twentyfivefishinthetoilet/mallow/cad/README.md

## the assembled and disassembled file is twice the size that github will let me upload...

find the assembled and disassembled models here: https://cad.onshape.com/documents/8d28d937ee2f633915ee1e28/w/bbd2f0516e2d8f6c5a6715a7/e/e605bfe08fafb4b1c2a4257e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 

sorry for the inconvenience :(
