twentyfivefishinthetoilet/mallow/bom.csv

Item Name | Qty | Price (total) (USD) | Item link | Notes | Backup links (Digikey/Amazon)
misc. SMD 0805 caps | 1 | $3.32 | https://www.aliexpress.us/item/2251832835333921.html | this applies for everything on aliexpress: listings may go down, prices may fluctuate. everything listed here is what i paid for as of october 2026. | https://a.co/d/07zyfSbP
misc. SMD 0603 resistors | 1 | $2.59 | https://www.aliexpress.us/item/3256811933609419.html |  | https://a.co/d/0jb2nH2L
USB-C ports (12pin) | 1 | $2.12 | https://www.aliexpress.us/item/3256812000821907.html |  | https://a.co/d/01DCsopN
2x10 2.54mm Female Header | 1 | $2.18 | https://www.aliexpress.us/item/3256805557045362.html | one for the game cartridge port, one of them for the controller port | https://www.digikey.com/en/products/detail/marutsuelec/21602X10GRE/21669225
2x10 2.54mm Male Header | 1 | $5.27 | https://www.aliexpress.us/item/2255801071217675.html?curPageLogUid=68oLz2krU5b1 | one for the game cartridge, one of them for the controller | https://www.digikey.com/en/products/detail/w-rth-elektronik/61302021021/4846861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
ESP32 S3 | 1 | $7.65 | https://www.aliexpress.us/item/3256805599889662.html | wroom 1u (n16r8 variant) | https://www.digikey.com/en/products/detail/espressif-systems/ESP32-S3-WROOM-1U-N16R8/16162641
LD1117S33TR | 1 | $1.61 | https://www.aliexpress.us/item/2251832820774962.html | voltage regulator 5v -> 3.3v | https://www.digikey.com/en/products/detail/stmicroelectronics/LD1117S33TR/585766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
ST7789 40pin | 1 | $14.43 | https://www.aliexpress.us/item/3256805323917526.html | Bundle: IPS Capacitive | couldn't find a backup link for this one, but this listing keeps popping up all over aliexpress. look up "2.8 inch TFT display 40PIN IPS full viewing angle", and if it matches the pinout on my schematic, then you're golden
FPC connector | 2 | $4.45 | https://www.aliexpress.us/item/3256812318345505.html | one order 6 pins at 0.5mm pitch, another at 40 pins at 0.5mm pitch | https://www.digikey.com/en/products/detail/amphenol-icc-fci-/62684-401100AHLF/4272376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
TF/microSD card slot | 1 | $8.71 | https://www.aliexpress.us/item/3256813046919379.html |  | https://www.digikey.com/en/products/detail/same-sky-formerly-cui-devices-/MSD-9-A/21796102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
MCP23017T-E/SS | 1 | $7.63 | https://www.aliexpress.us/item/3256812791682296.html |  | https://www.digikey.com/en/products/detail/microchip-technology/MCP23017T-E-SS/964185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
push buttons | 1 | $1.78 | https://www.aliexpress.us/item/3256802301084670.html | 6x6x6mm | https://www.amazon.com/Momentary-Terminal-Pushbutton-Breadboard-Electronic/dp/B09R3ZPWJ7
push buttons (smd) | 1 | $2.22 | https://www.aliexpress.us/item/3256811531075750.html?curPageLogUid=lURo5QRmlVZe | 3×6×2.5mm | https://www.amazon.com/100pcs-3X6X2-5mm-Tactile-Button-Switch/dp/B0F7GGCFCY
charging module | 1 | $2.25 | https://www.aliexpress.us/item/3256810363878930.html?curPageLogUid=32djJhgpSeSi | Color: TP4056 MICRO 5PCS | https://www.amazon.com/DEVMO-Charging-Lithium-Protection-Function/dp/B07S5ZV8FD?sp_csd=d2lkZ2V0TmFtZT1zcF9hdGY
3.7V 602030 300mAh | 1 | $6.44 | https://www.aliexpress.us/item/3256812728637526.html?curPageLogUid=clhgQjHo0G6X | this isnt the exact battery i have, but it's the closest i could find. same power rating, maybe different dimensions. | https://www.amazon.com/BORNMIO-Lithium-Polymer-Rechargeable-Connector/dp/B0D4V7KLSV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
misc: jumper wires, switch, etc |  | $5.00 | - | 5 is a generous grace amount for jumper wires, a switch for the power pak, and 1x2 female header pins (optional). | -
W25Q128FWSIQ | 1 | $2.81 | https://www.aliexpress.us/item/3256808455873288.html?curPageLogUid=pTRUNNN6MLek |  | https://www.amazon.com/5PCS-25Q128FWSQ-W25Q128FWSQ-W25Q128FWSIQ-SOP8/dp/B0C557DY1J
Total Price (USD) (FROM ALIEXPRESS): | $80.46
