twentyfivefishinthetoilet/mallow/cad/controller/base_bottom.stl

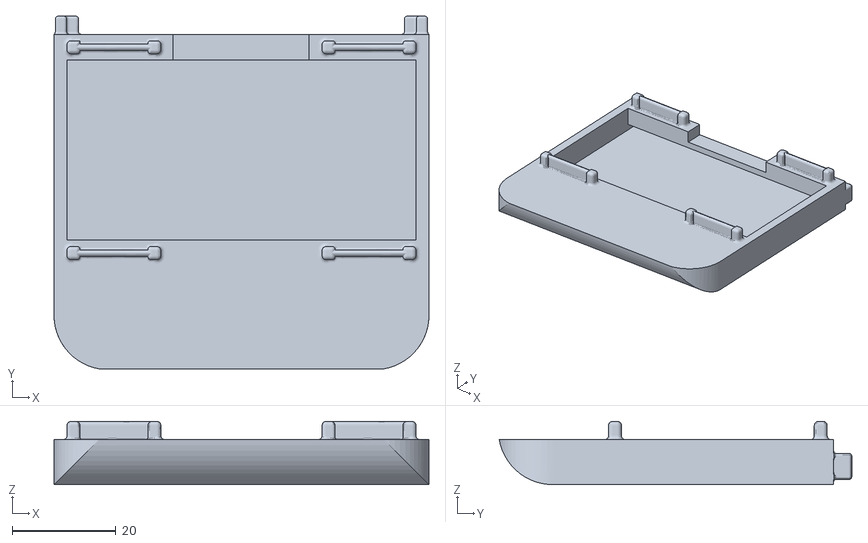
[picture p5: CAD file, 2026-10-20]
cad/controller/base_bottom.stl
72.3 x 68.0 x 12.2
