twentyfivefishinthetoilet/mallow/cad/game_cartridge/Part Studio 3 - Part 2.obj

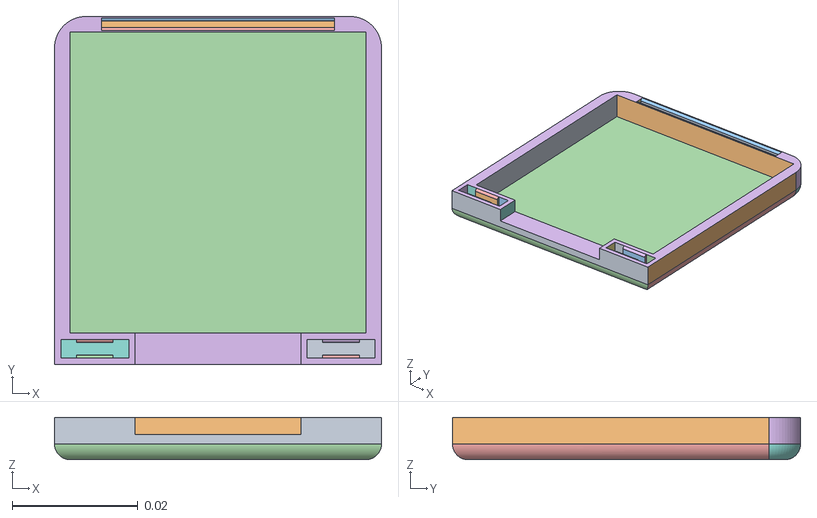
[picture p6: CAD file, 2026-10-19]
cad/game_cartridge/Part Studio 3 - Part 2.obj
0.052 x 0.0553 x 0.00675
