twentyfivefishinthetoilet/mallow/cad/main_board/Part Studio 1 - Part 3.obj

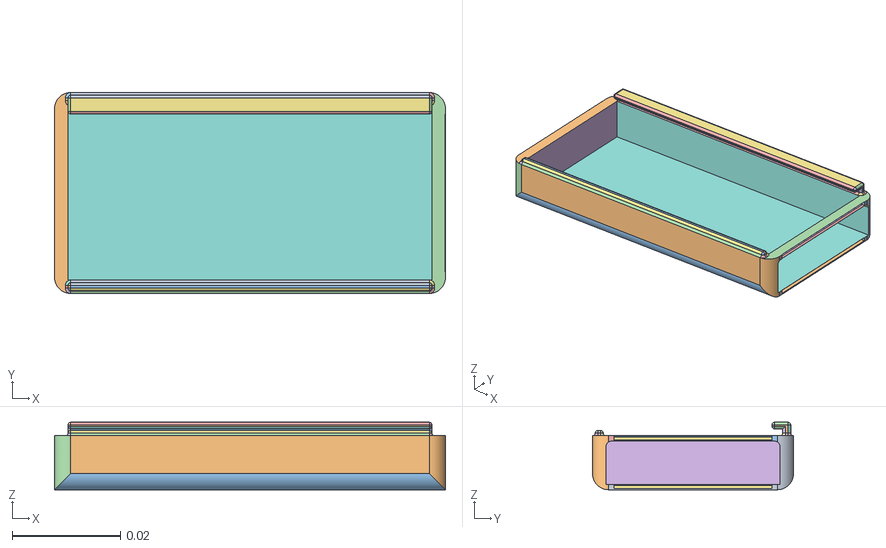
[picture p7: CAD file, 2026-10-19]
cad/main_board/Part Studio 1 - Part 3.obj
0.0723 x 0.0372 x 0.0125
