twentyfivefishinthetoilet/mallow/cad/STEP/controller_step/top.step

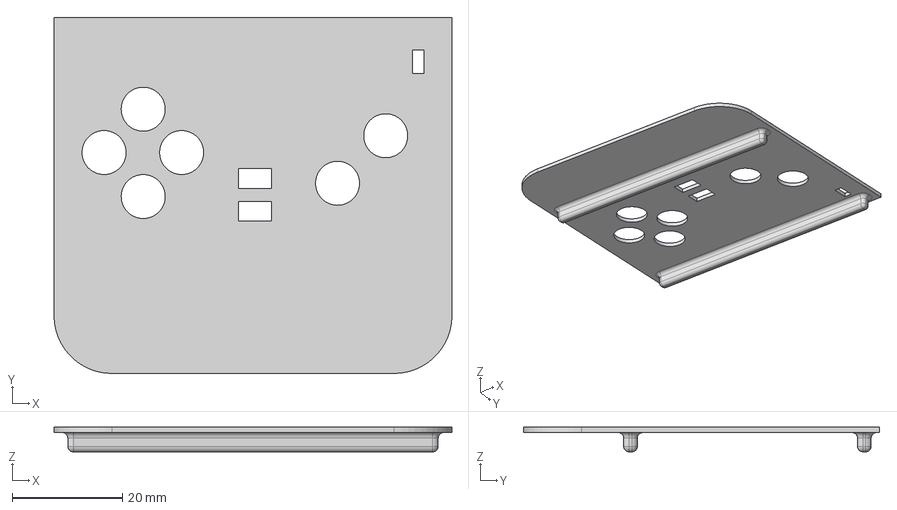
[picture p8: CAD file, 2026-10-23]
cad/STEP/controller_step/top.step
72.4 x 64.7 x 4.50 mm
