twentyfivefishinthetoilet/mallow/cad/STEP/game_cartridge_step/bottom.step

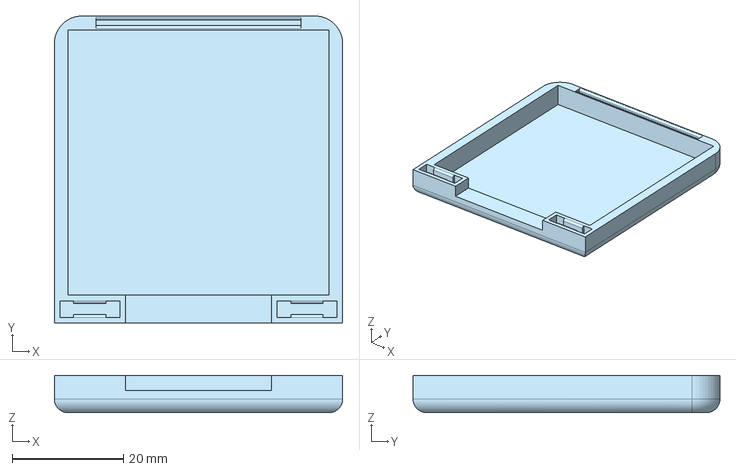
[picture p9: CAD file, 2026-10-23]
cad/STEP/game_cartridge_step/bottom.step
52.0 x 55.3 x 6.75 mm
