twentyfivefishinthetoilet/mallow/cad/STEP/main_board_step/power_pak.step

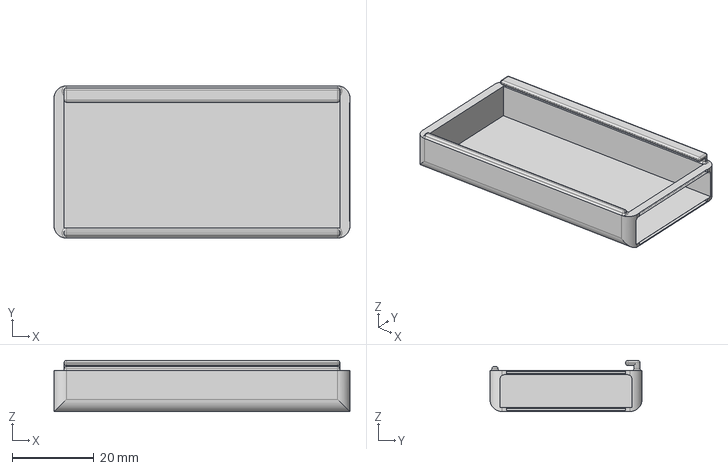
[picture p10: CAD file, 2026-10-23]
cad/STEP/main_board_step/power_pak.step
72.4 x 37.2 x 12.5 mm
