twentyfivefishinthetoilet/mallow/cad/STL/controller/buttons_A.stl

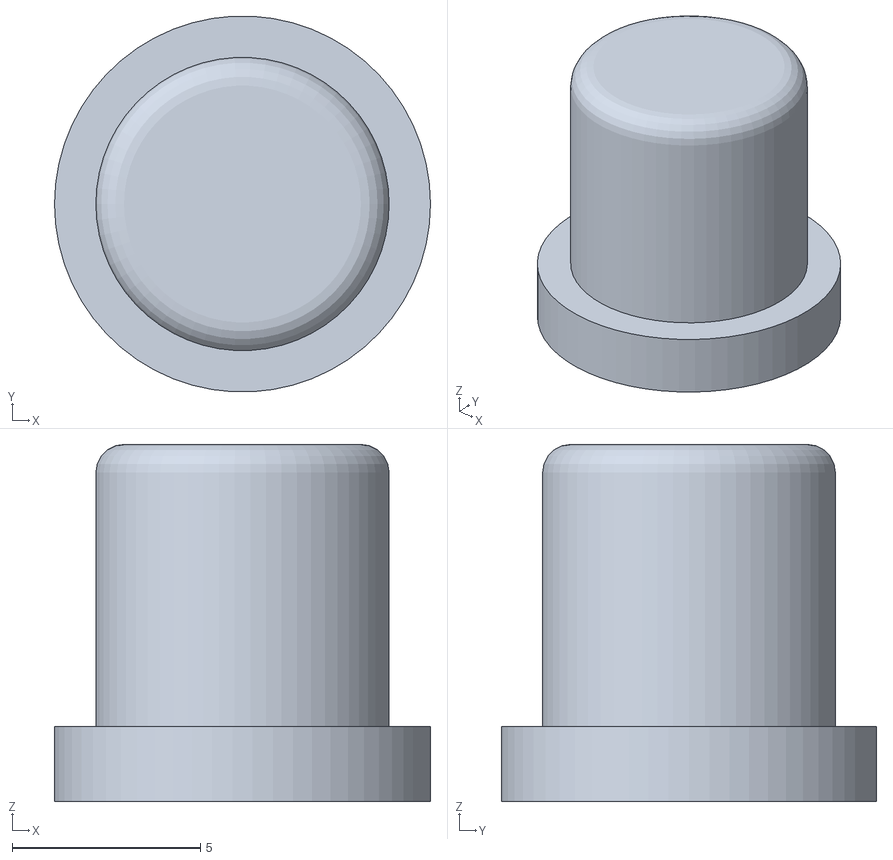
[picture p11: CAD file, 2026-10-23]
cad/STL/controller/buttons_A.stl
10.0 x 9.99 x 9.50
