twentyfivefishinthetoilet/mallow/cad/controller/base_middle.stl

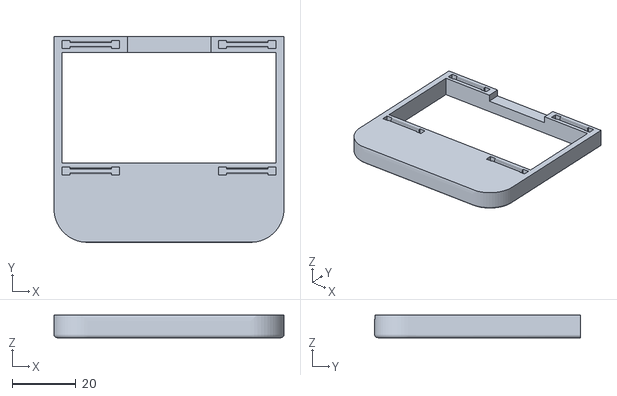
[picture p12: CAD file, 2026-10-20]
cad/controller/base_middle.stl
72.3 x 64.7 x 7.08
