twentyfivefishinthetoilet/mallow/cad/game_cartridge/Part Studio 3 - Part 1.obj

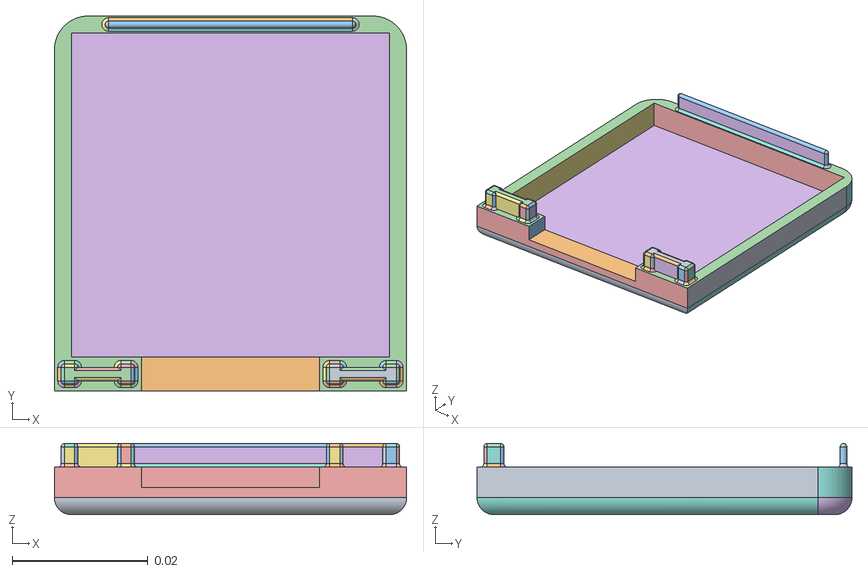
[picture p13: CAD file, 2026-10-19]
cad/game_cartridge/Part Studio 3 - Part 1.obj
0.0519 x 0.0553 x 0.0105
