twentyfivefishinthetoilet/mallow/cad/main_board/Part Studio 1 - Part 2.obj

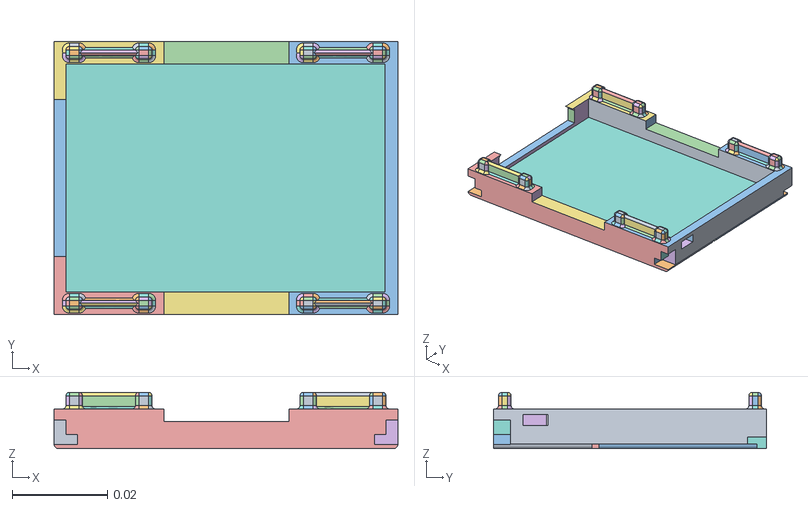
[picture p14: CAD file, 2026-10-19]
cad/main_board/Part Studio 1 - Part 2.obj
0.0723 x 0.0573 x 0.0119
