twentyfivefishinthetoilet/mallow/cad/STEP/controller_step/dpad.step

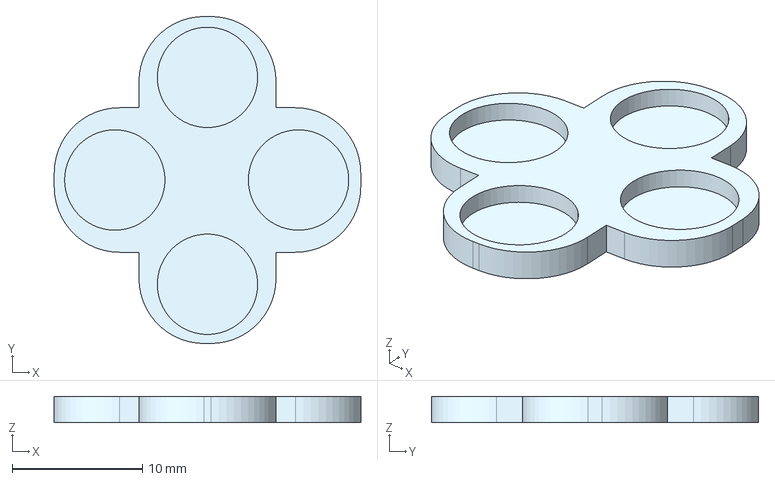
[picture p15: CAD file, 2026-10-23]
cad/STEP/controller_step/dpad.step
23.5 x 25.1 x 2.00 mm
