twentyfivefishinthetoilet/mallow/cad/STEP/game_cartridge_step/top.step

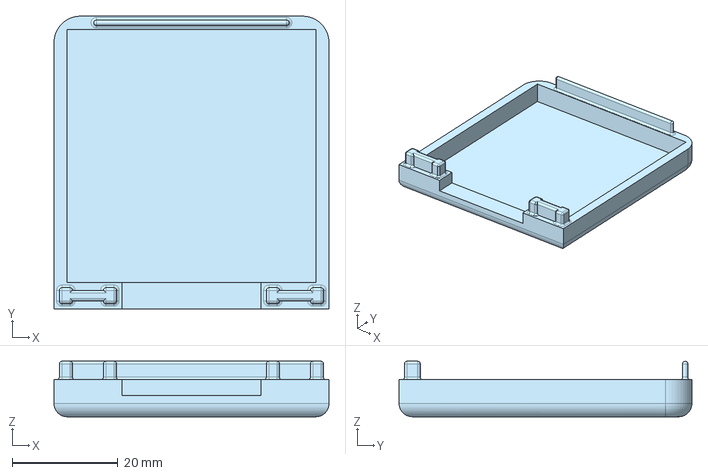
[picture p16: CAD file, 2026-10-23]
cad/STEP/game_cartridge_step/top.step
51.9 x 55.3 x 10.5 mm
