twentyfivefishinthetoilet/mallow/cad/STEP/main_board_step/bottom.step

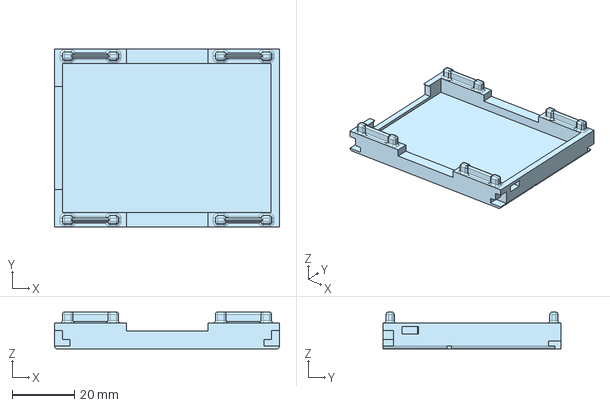
[picture p17: CAD file, 2026-10-23]
cad/STEP/main_board_step/bottom.step
72.4 x 57.3 x 11.9 mm
