twentyfivefishinthetoilet/mallow/cad/STL/controller/buttons_A_cover.stl

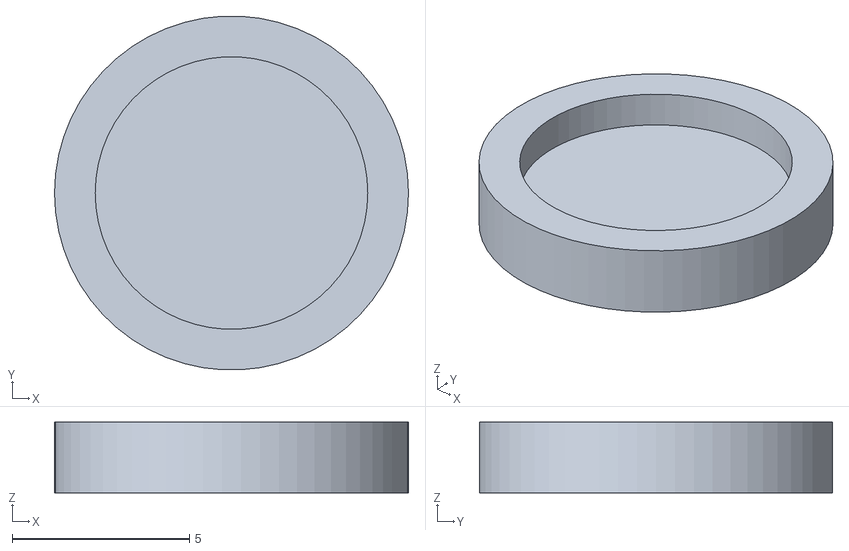
[picture p18: CAD file, 2026-10-23]
cad/STL/controller/buttons_A_cover.stl
10.0 x 9.99 x 2.00
