twentyfivefishinthetoilet/mallow/cad/main_board/Part Studio 1 - Part 1.obj

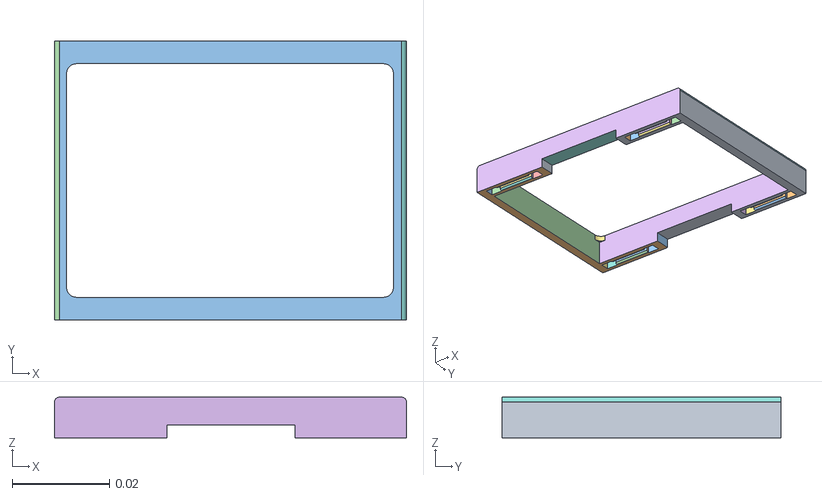
[picture p19: CAD file, 2026-10-19]
cad/main_board/Part Studio 1 - Part 1.obj
0.0724 x 0.0573 x 0.00838
