twentyfivefishinthetoilet/mallow/cad/STEP/main_board_step/top.step

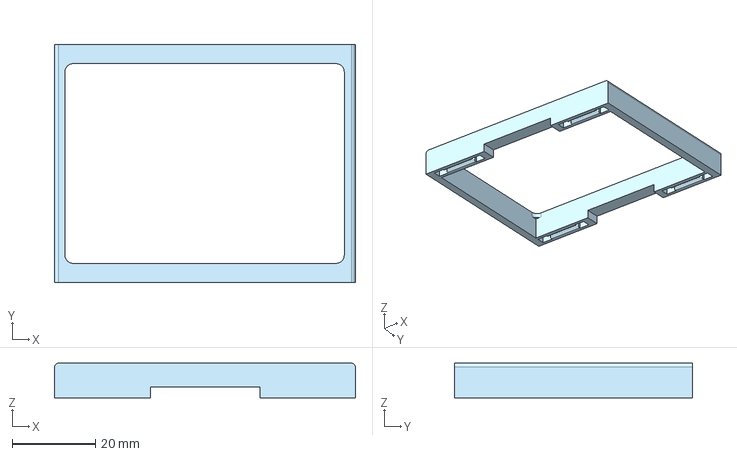
[picture p20: CAD file, 2026-10-23]
cad/STEP/main_board_step/top.step
72.3 x 57.3 x 8.38 mm
