twentyfivefishinthetoilet/mallow/cad/controller/Part Studio 2 - Part 3.obj

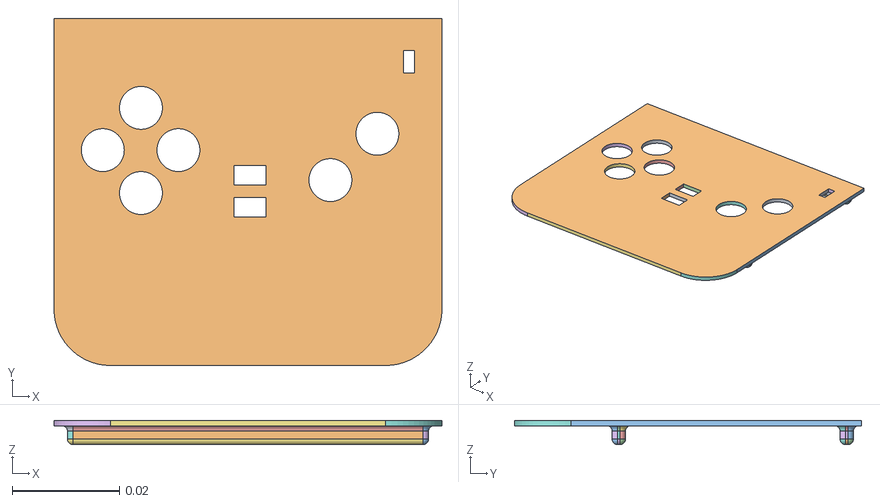
[picture p21: CAD file, 2026-10-19]
cad/controller/Part Studio 2 - Part 3.obj
0.0724 x 0.0647 x 0.0045
