twentyfivefishinthetoilet/mallow/cad/controller/Part Studio 2 - Part 7.obj

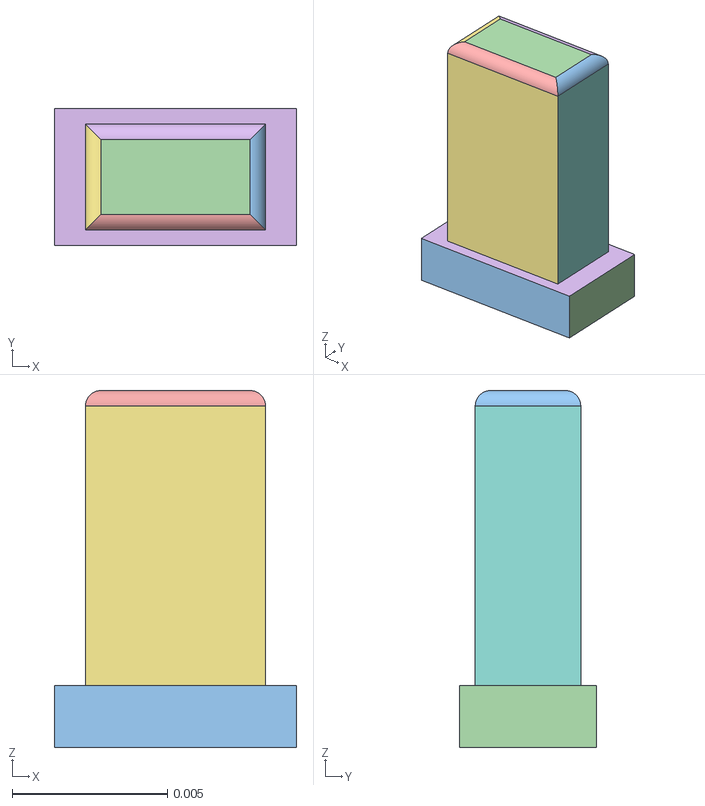
[picture p22: CAD file, 2026-10-19]
cad/controller/Part Studio 2 - Part 7.obj
0.0078 x 0.0044 x 0.0115
