twentyfivefishinthetoilet/mallow/cad/STEP/controller_step/button_A.step

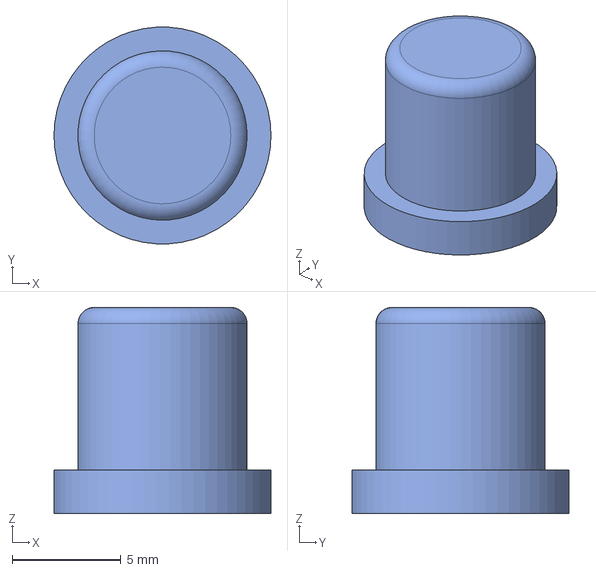
[picture p23: CAD file, 2026-10-23]
cad/STEP/controller_step/button_A.step
10.00 x 9.98 x 9.50 mm
