twentyfivefishinthetoilet/mallow/cad/controller/Part Studio 2 - Part 5.obj

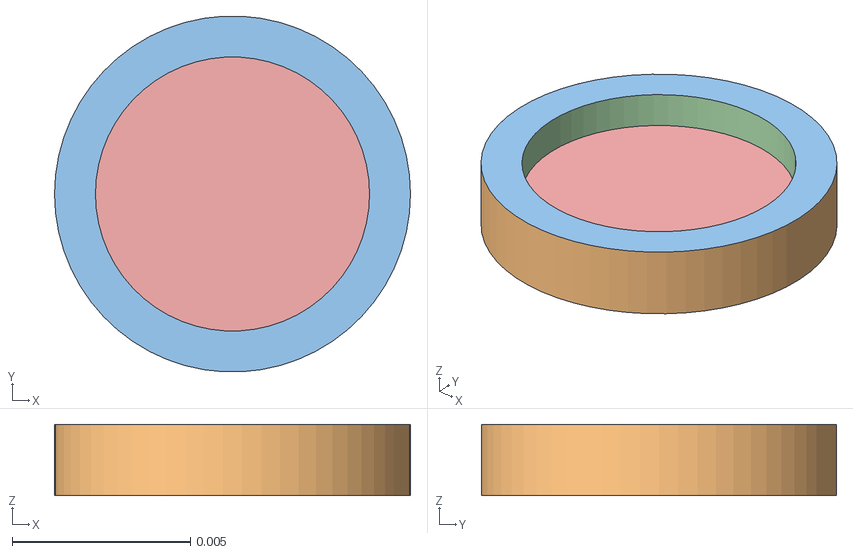
[picture p24: CAD file, 2026-10-19]
cad/controller/Part Studio 2 - Part 5.obj
0.01 x 0.00999 x 0.002
