twentyfivefishinthetoilet/mallow/cad/STEP/controller_step/buttons_B.step

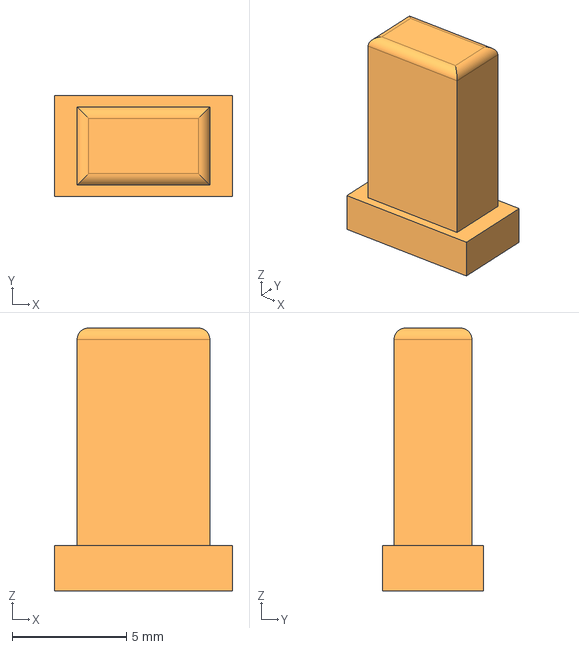
[picture p25: CAD file, 2026-10-23]
cad/STEP/controller_step/buttons_B.step
7.80 x 4.40 x 11.5 mm
