twentyfivefishinthetoilet/mallow/cad/controller/Part Studio 2 - Part 2.obj

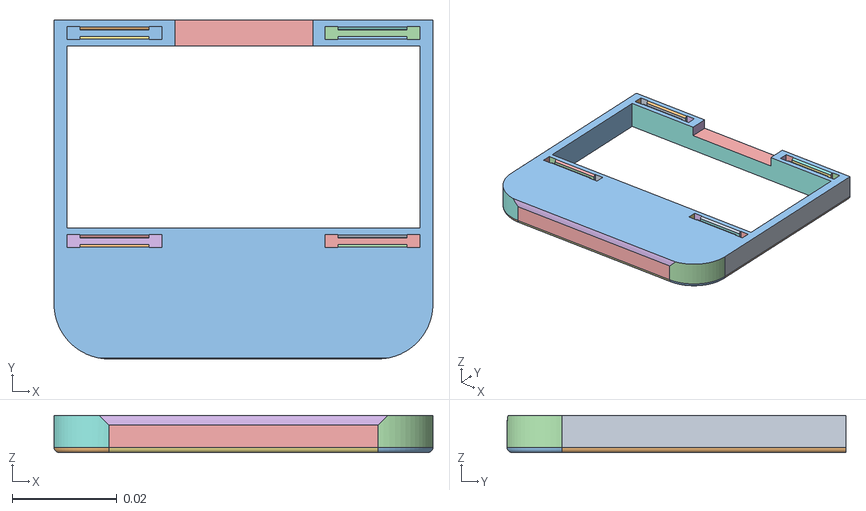
[picture p26: CAD file, 2026-10-19]
cad/controller/Part Studio 2 - Part 2.obj
0.0723 x 0.0647 x 0.00708
