twentyfivefishinthetoilet/mallow/cad/controller/Part Studio 2 - Part 8.obj

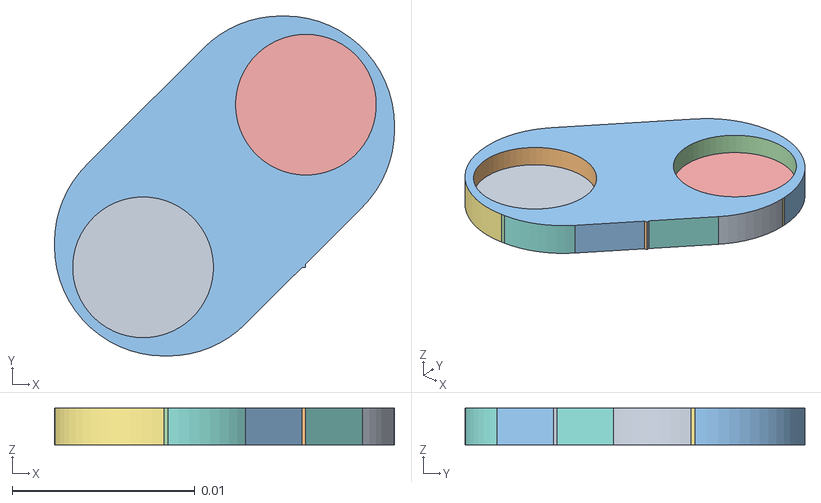
[picture p27: CAD file, 2026-10-19]
cad/controller/Part Studio 2 - Part 8.obj
0.0186 x 0.0186 x 0.002
