twentyfivefishinthetoilet/mallow/cad/controller/Part Studio 2 - Part 6.obj

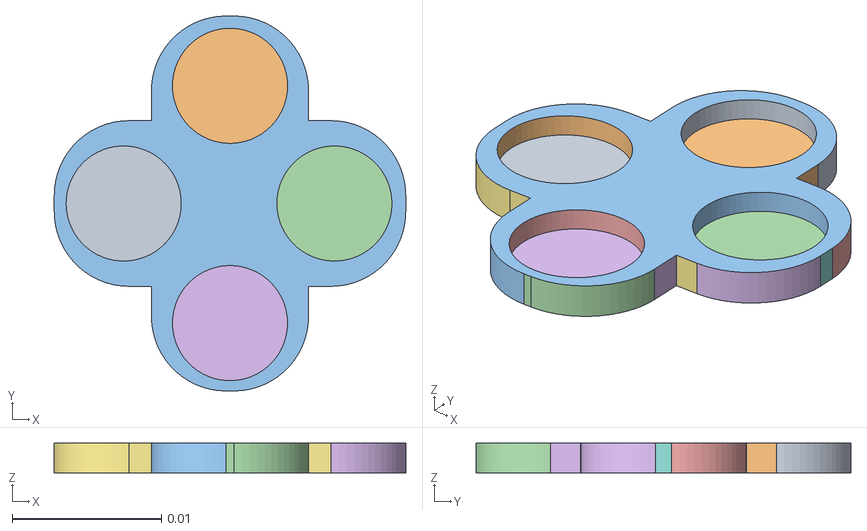
[picture p28: CAD file, 2026-10-19]
cad/controller/Part Studio 2 - Part 6.obj
0.0235 x 0.0251 x 0.002
