twentyfivefishinthetoilet/mallow/cad/controller/Part Studio 2 - Part 4.obj

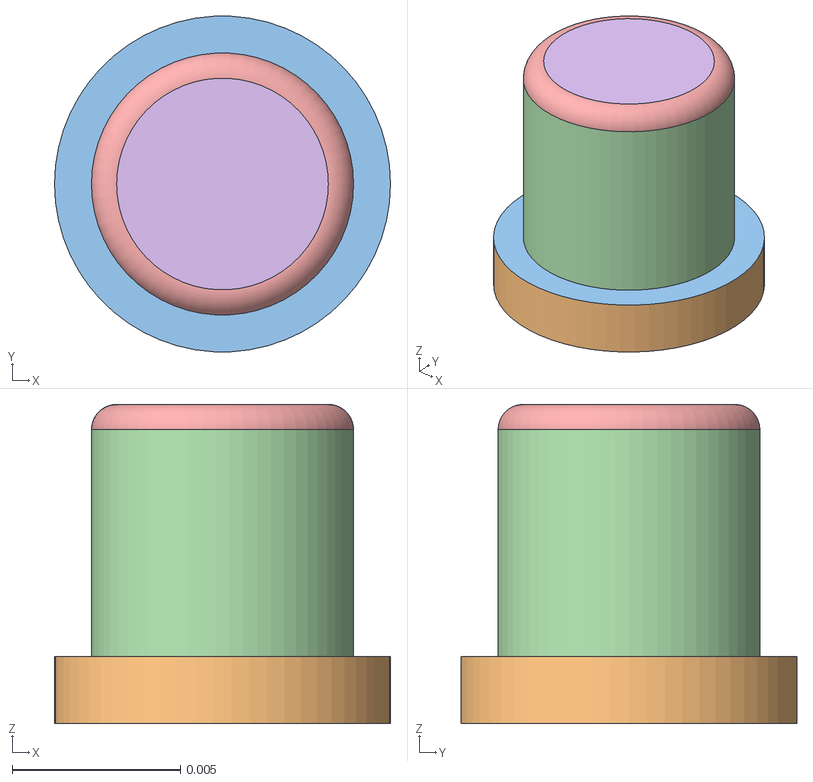
[picture p29: CAD file, 2026-10-19]
cad/controller/Part Studio 2 - Part 4.obj
0.01 x 0.00999 x 0.0095
