twentyfivefishinthetoilet/mallow/cad/controller/Part Studio 2 - Part 1.obj

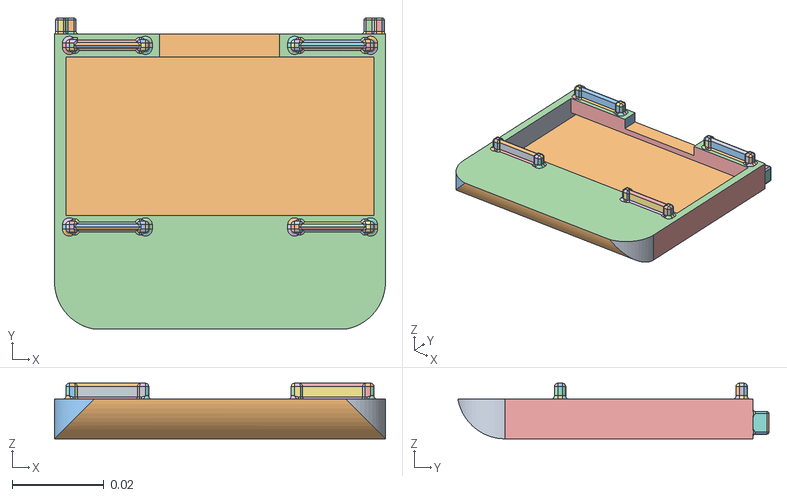
[picture p30: CAD file, 2026-10-19]
cad/controller/Part Studio 2 - Part 1.obj
0.0723 x 0.068 x 0.0122
