twentyfivefishinthetoilet/mallow/(list of files, cad)

Other CAD files:
cad/controller/base_top.stl
cad/STEP/controller_step/bottom.step
cad/STEP/controller_step/middle.step
cad/STEP/controller_step/button_A_cover.step
cad/STL/main_board/power_pak.stl
cad/STL/main_board/top.stl
cad/controller/buttons_B.stl
cad/controller/dpad.stl
cad/game_cartridge/bottom.stl
cad/game_cartridge/top.stl
cad/main_board/bottom.stl
