twentyfivefishinthetoilet/mallow/pcb/controller/controller_sch.pdf

# FLASH MEMORY

# CURRENT BUTTON LAYOUT

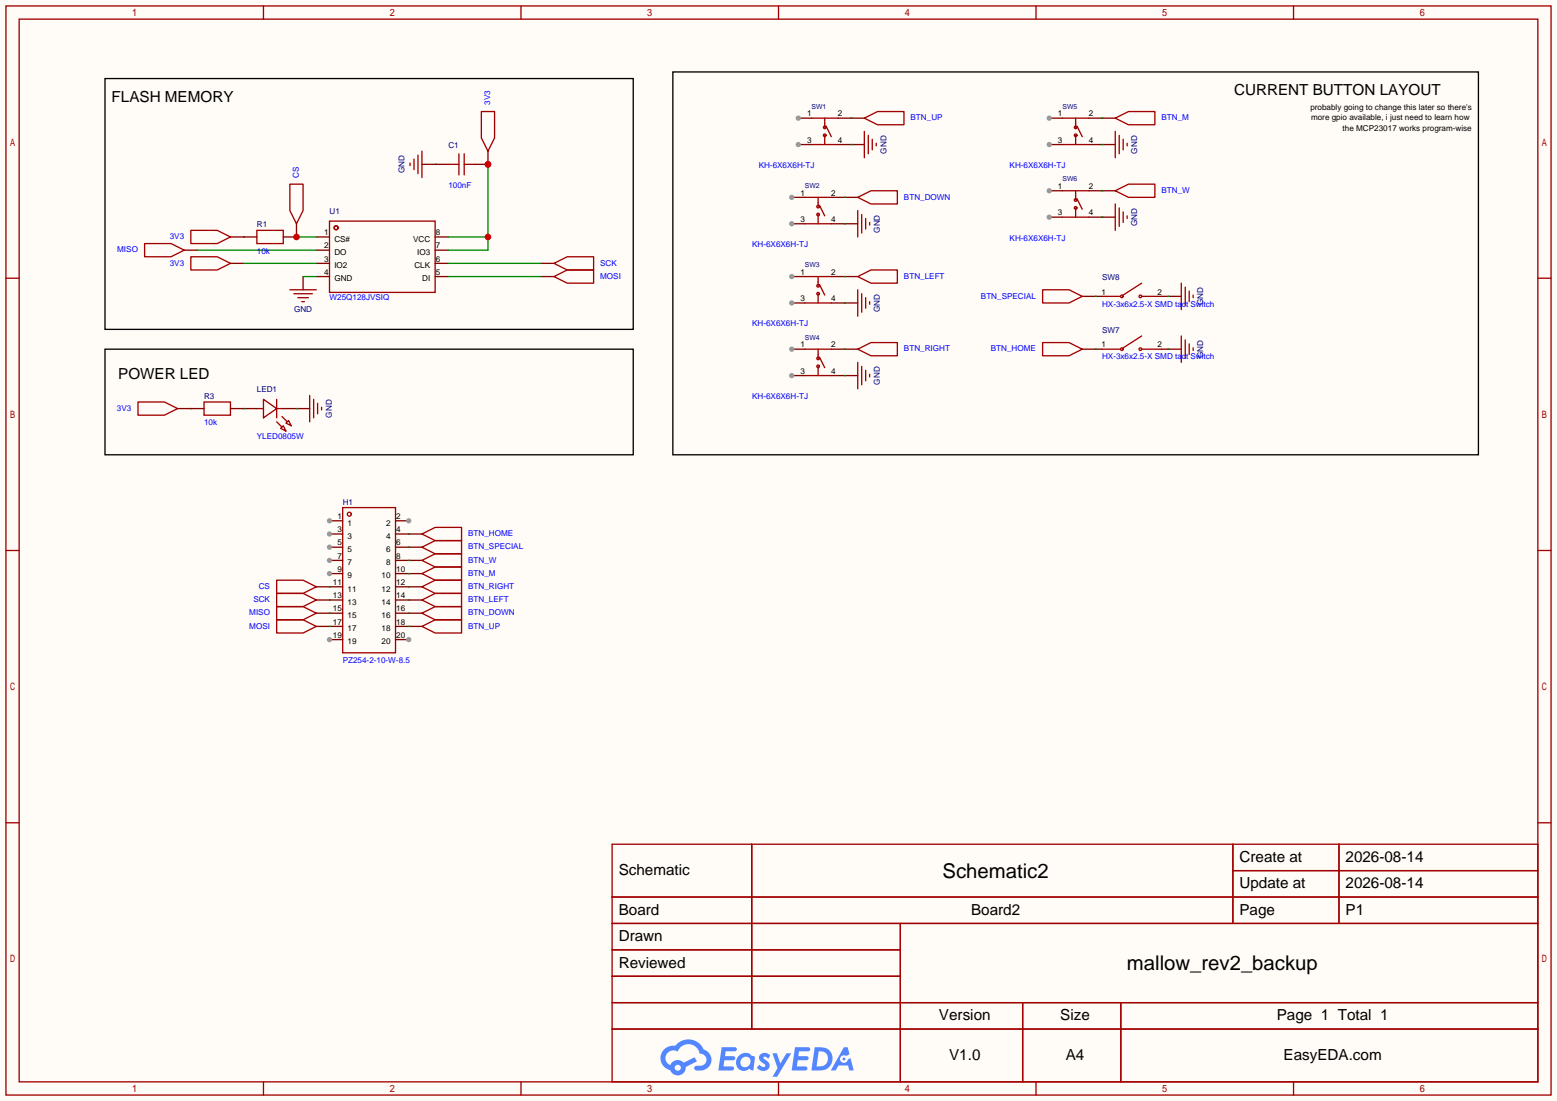
[picture p31: page 1]

probably going to change this later so there's
more gpio available, i just need to learn how
the MCP23017 works program-wise

HX-3x6x2.5-X SMD tact Switch

Schematic | Schematic2 | Create at | 2026-08-14

Update at | 2026-08-14

Board | Board2 | Page | P1
Drawn | | mallow_rev2_backup
Reviewed

Version | Size | Page 1 Total 1

V1.0 | A4 | EasyEDA.com
