twentyfivefishinthetoilet/mallow/pcb/game_cartridge/cartridge_sch.pdf

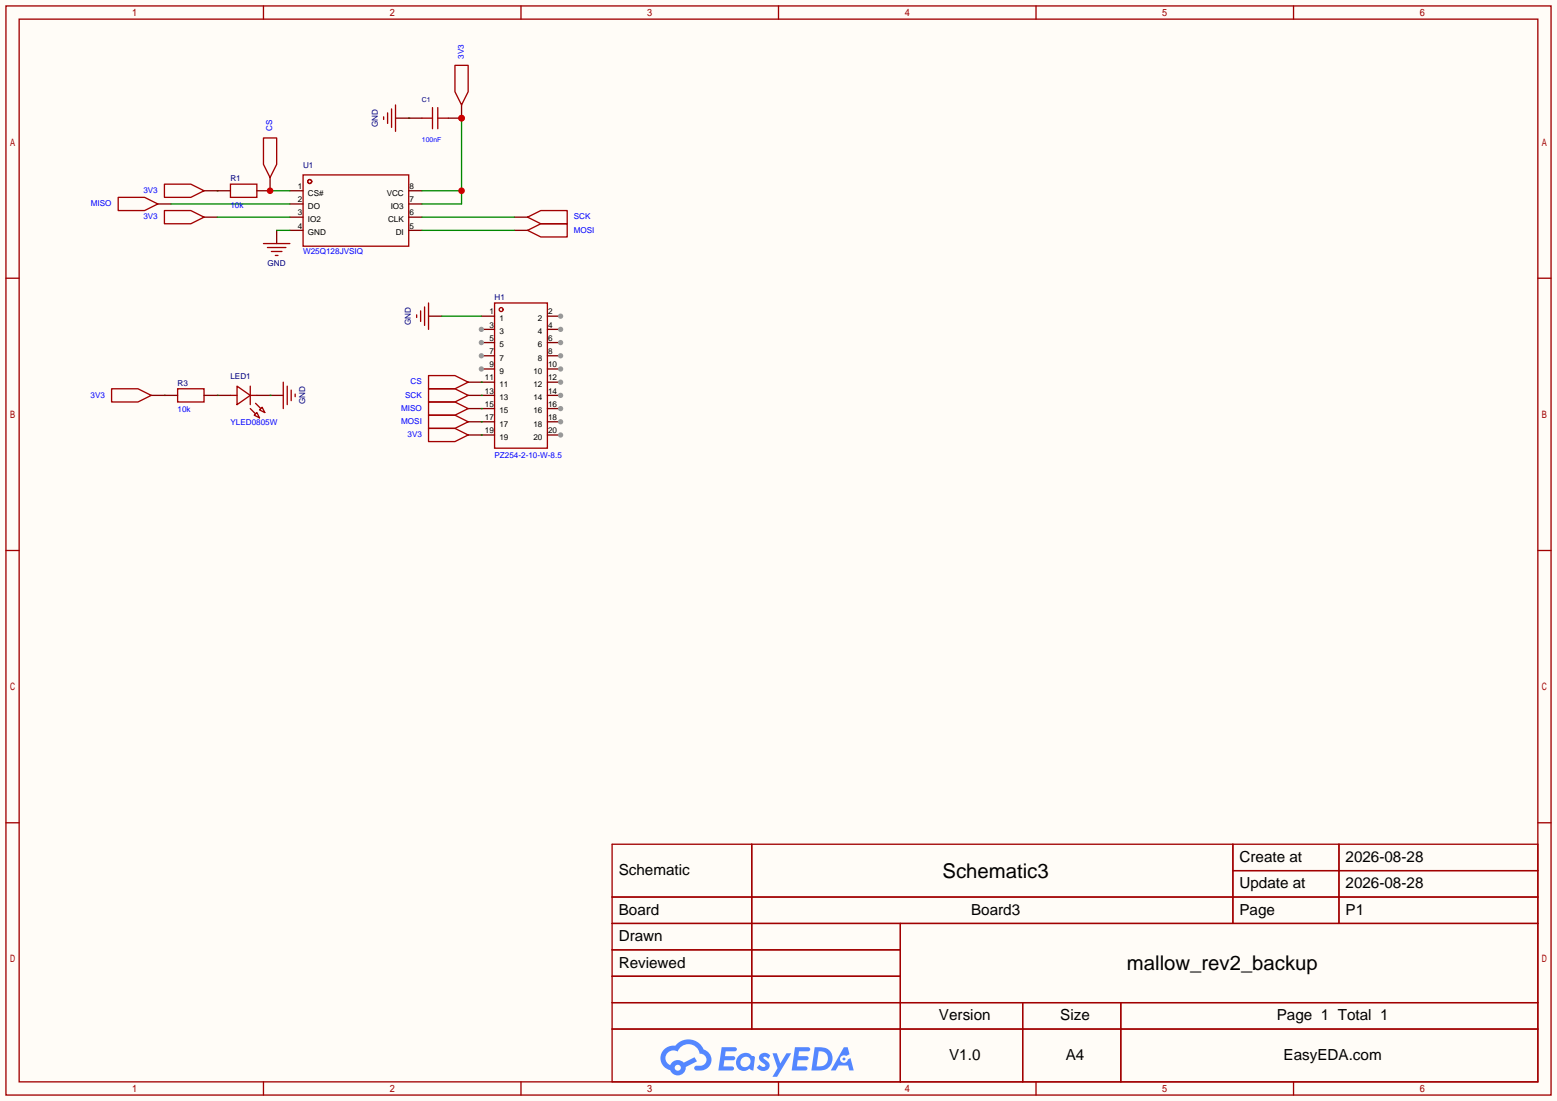
[picture p32: page 1]

Schematic | Schematic3 | Create at | 2026-08-28

Update at | 2026-08-28

Board | Board3 | Page | P1
Drawn | | mallow_rev2_backup
Reviewed

Version | Size | Page 1 Total 1

V1.0 | A4 | EasyEDA.com
