twentyfivefishinthetoilet/mallow/pcb/main_board/motherboard_sch.pdf

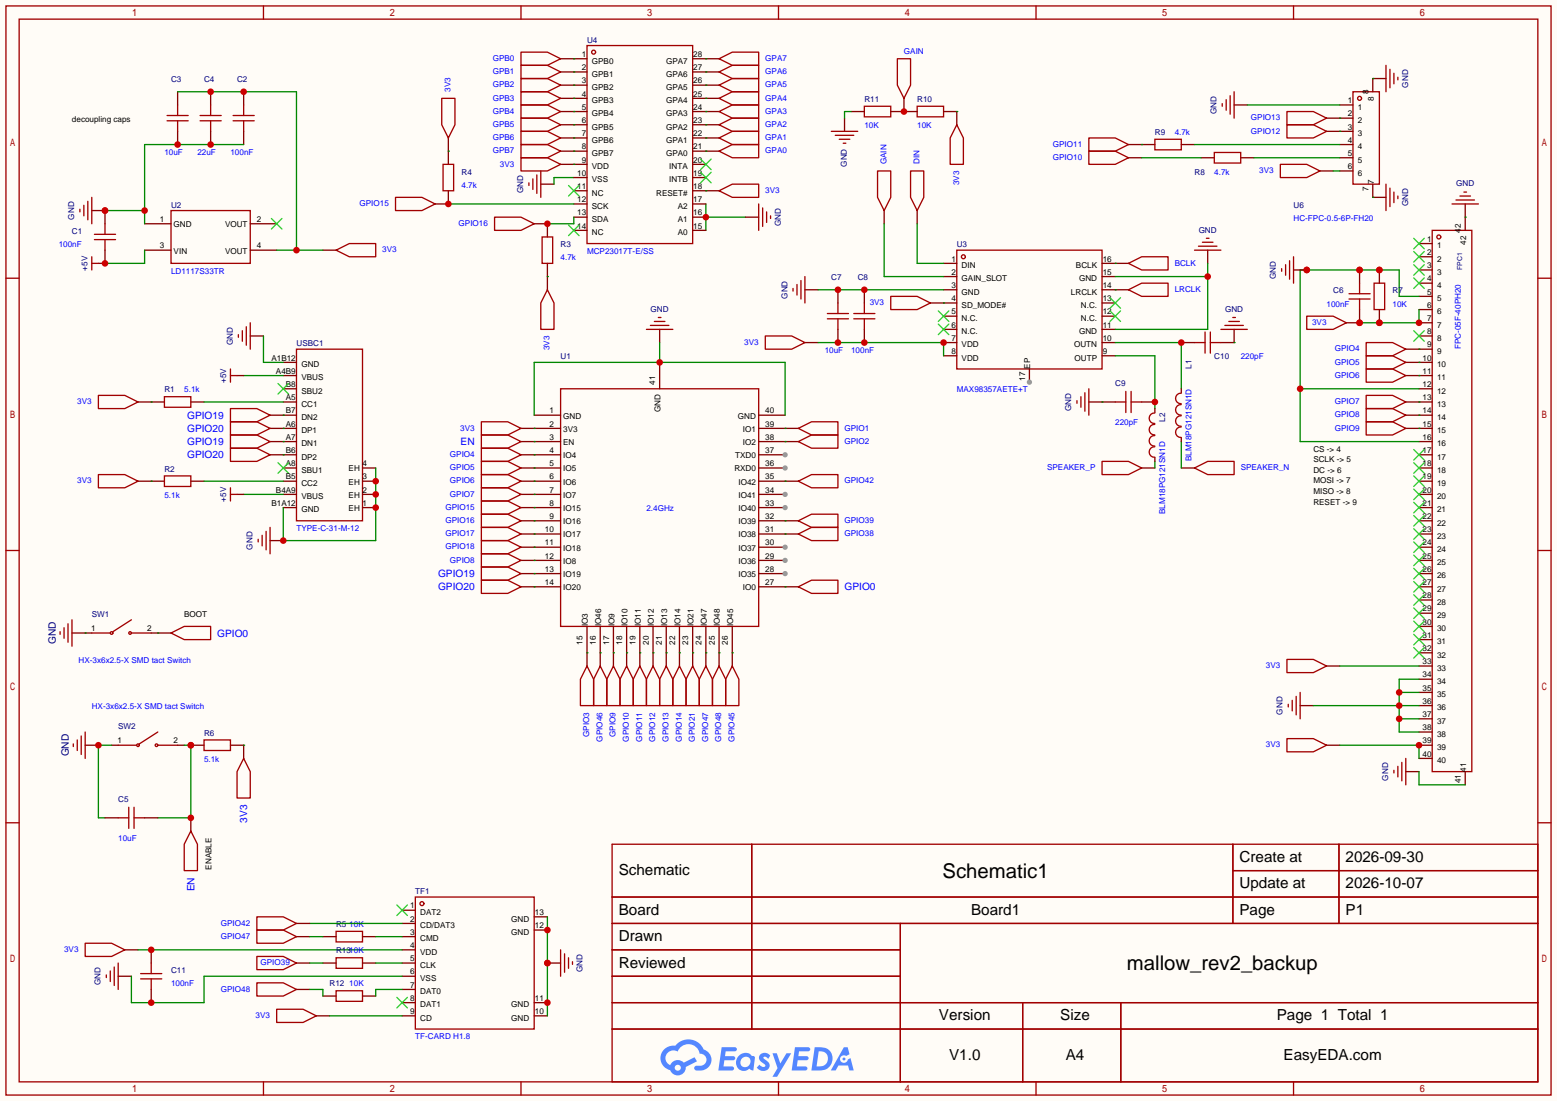
[picture p33: page 1]

HX-3x6x2.5-X SMD tact Switch

Schematic | Schematic1 | Create at | 2026-09-30

Update at | 2026-10-07

Board | Board1 | Page | P1
Drawn | | mallow_rev2_backup
Reviewed

Version | Size | Page 1 Total 1

V1.0 | A4 | EasyEDA.com
