twentyfivefishinthetoilet/mallow/(commit log)

2026-07-26 forge didn't like my layout, so now im changing it
    no more introductory stuff 😔
2026-07-26 day 1 progress and schematic details
2026-07-26 revised (wired) pcb and updated journal
2026-07-27 added main file from vscode
    currently, all this does is display the color 0xDEAD on the screen. im pretty sure its inverted, but im just happy this is working either way. inverting the display is an easy fix
2026-07-31 document day 3, spi study session
    how spi works and all that jazz
2026-08-04 uploaded icons.h
    soon it will be replaced with frames.h. at some point, these images will be .bin files on flash memory, but i didnt get that hooked up yet
2026-08-04 frames.h for main_804.c
    these are temporary, a placeholder until i get an actual game running
2026-08-09 main 8/8/26
    this file has been worked on for three days for a total of around 6 hours. implemented visual functions (draw pixel, draw rectangle, fill screen, etc), a "game loop" with delta time and update and render functions (in quotations for a reason i'll explain in the JOURNAL.md entry), and a flower/bomb sprite animation to test out dt.
2026-08-10 apology / promise
    i'll track time tomorrow i swear
2026-08-10 renamed journal.md to journal_old.md
    i need a fresh start regarding programming. now i know how to track time with hackatime, so im going to rewrite my programs with this.
2026-08-10 main.c for aug 10th
    covered the following:
    - esp lcd
    - buttons
    ...as well as a header file and source file for draw functions
2026-10-08 updated layout and uploaded files for main board
    [mallow_main_board_bom.csv, mallow_pickandplace.csv]
2026-10-08 mallow_bom.csv -> "BOM files"
2026-10-19 pcb files
2026-10-19 cad files pt 1
2026-10-19 added digital final assembly picture
2026-10-23 updated readme with assembly and firmware instructions
2026-10-23 where to find assembled STEP files
2026-10-23 added pictures of the circuit boards
2026-10-23 this formatting pmo 🥹
2026-10-28 uploaded new bom (old one with backup links)
